janelia-kicad/step_dir_controller_3x2/schematic/step_dir_controller_3x2.pdf

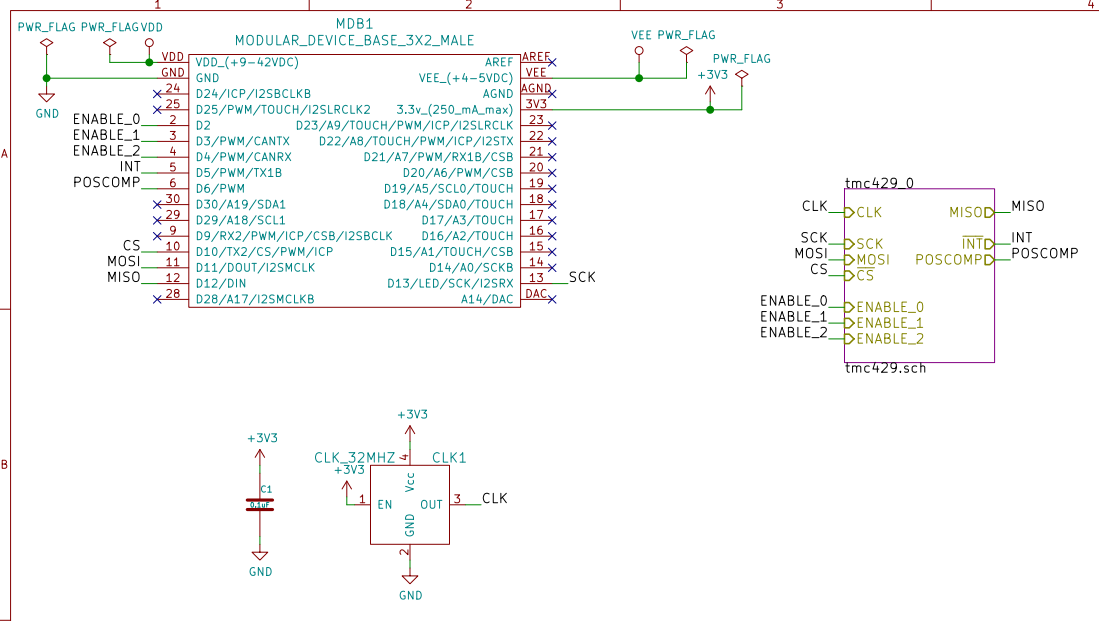
[picture p6: page 1]

File: step_dir_controller_3x2.sch Sheet: / Janelia

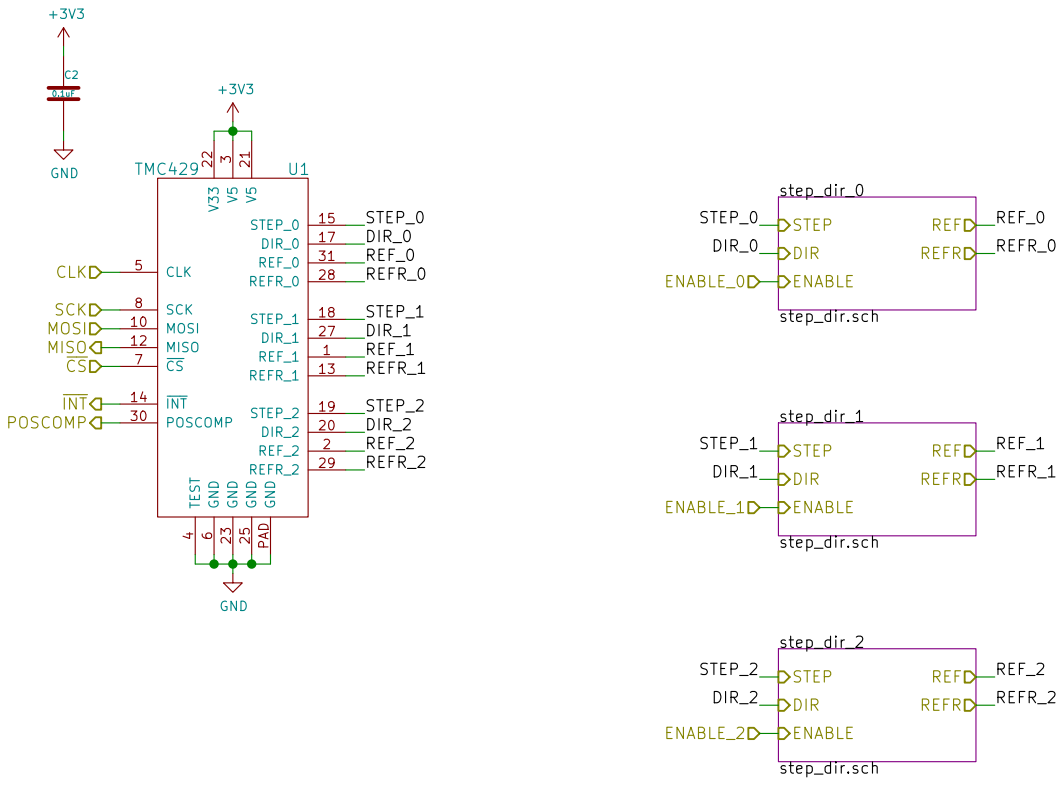
[picture p7: page 2]

6 CS 7 SCK 8 MOSI 10 DIR_2 POSCOMP 20

Id: 2/5 Title: File: tmc429.sch Sheet: /tmc429_0/

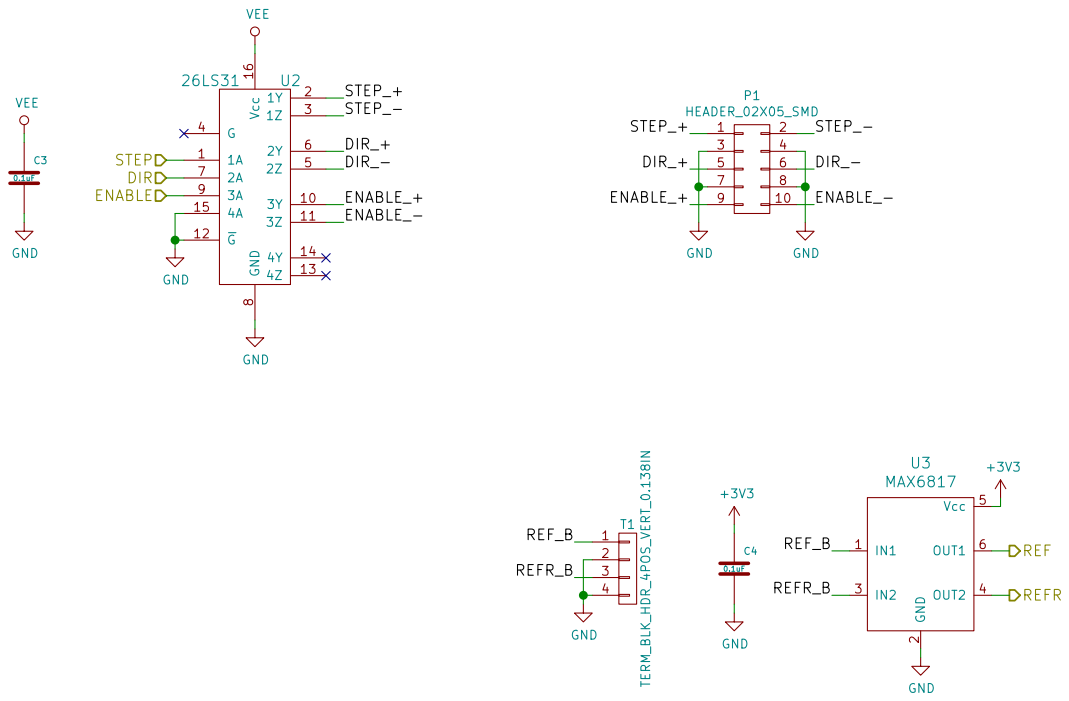
[picture p8: page 3]

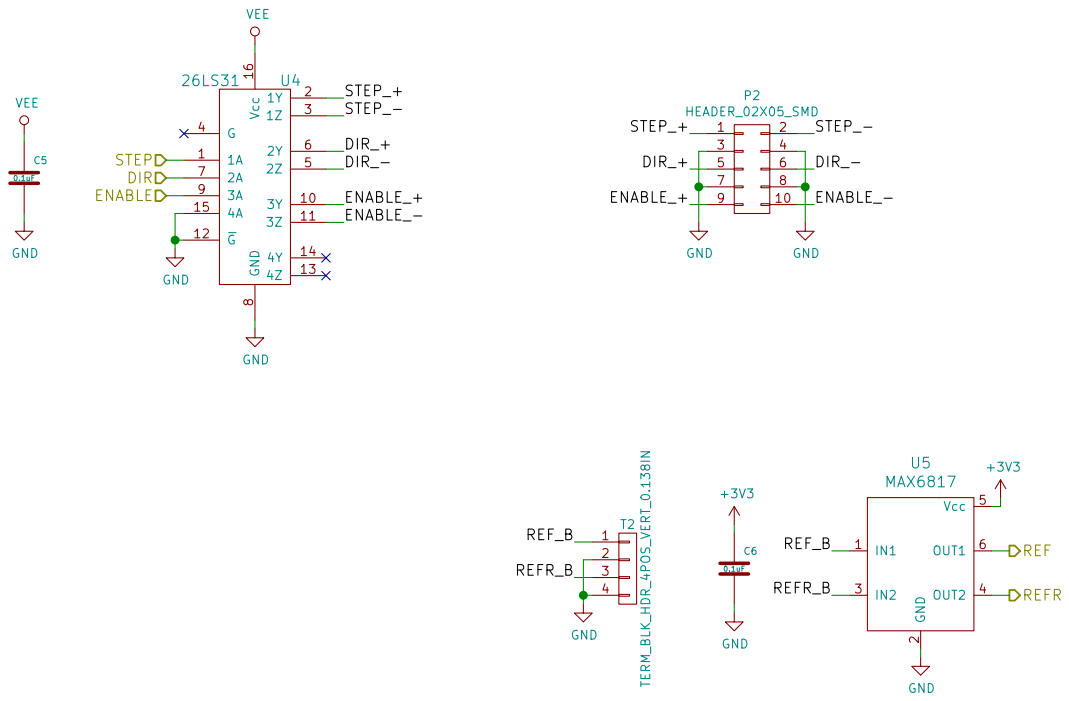
[picture p9: page 4]

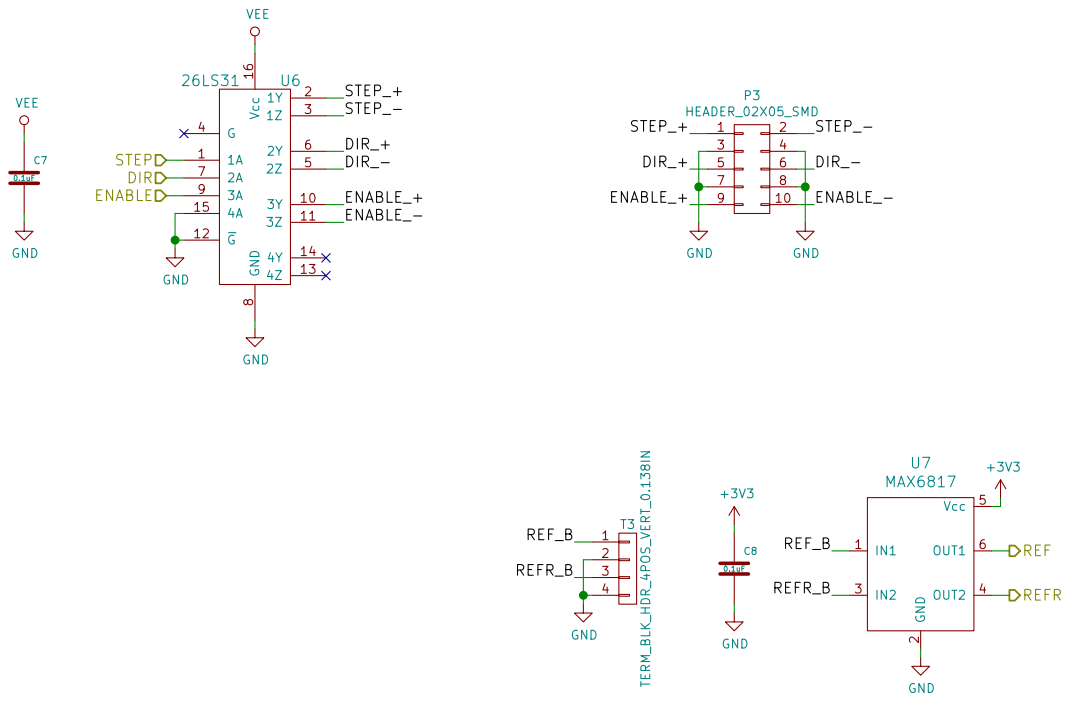
[picture p10: page 5]
