janelia-kicad/step_dir_controller_3x2/step_dir_controller_3x2.kicad_pcb

## KiCad design step_dir_controller_3x2.kicad_pcb (2017-03-29)

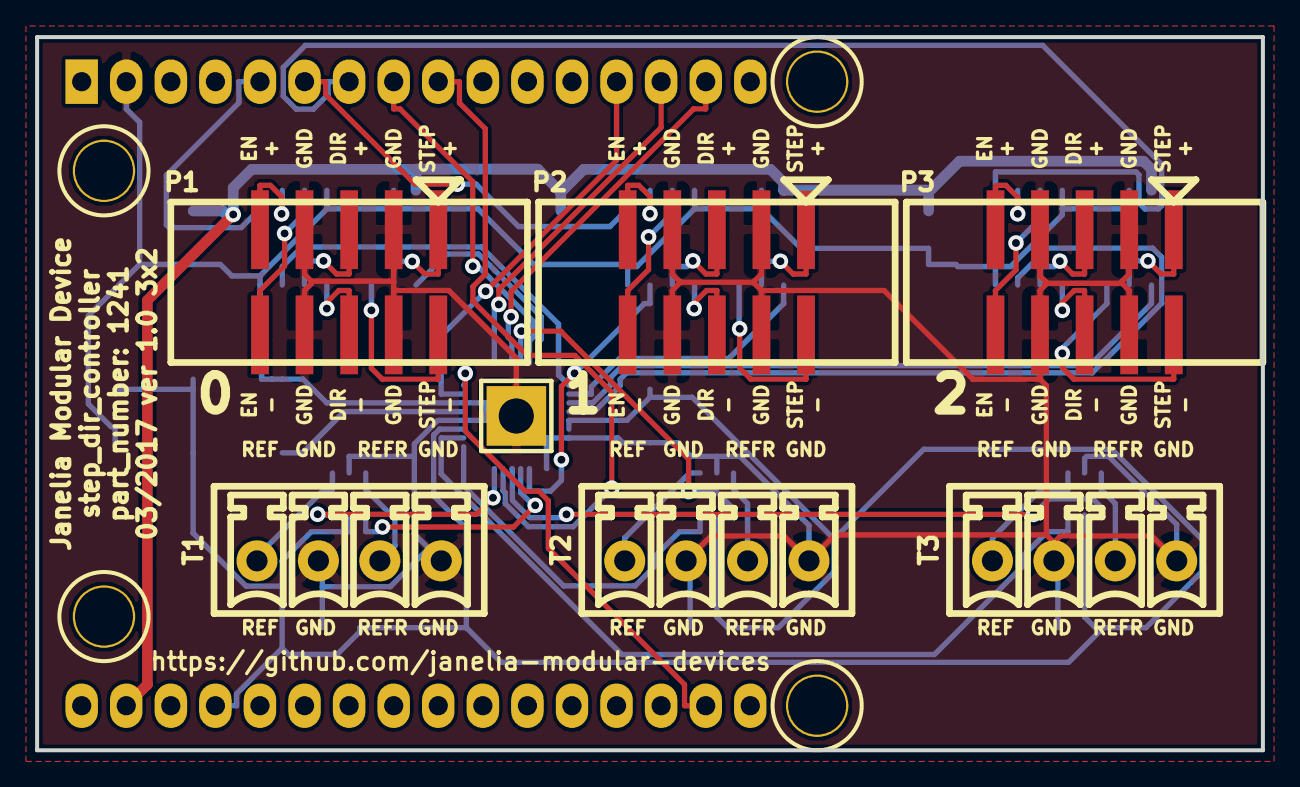
[picture p11: board step_dir_controller_3x2.kicad_pcb from above]

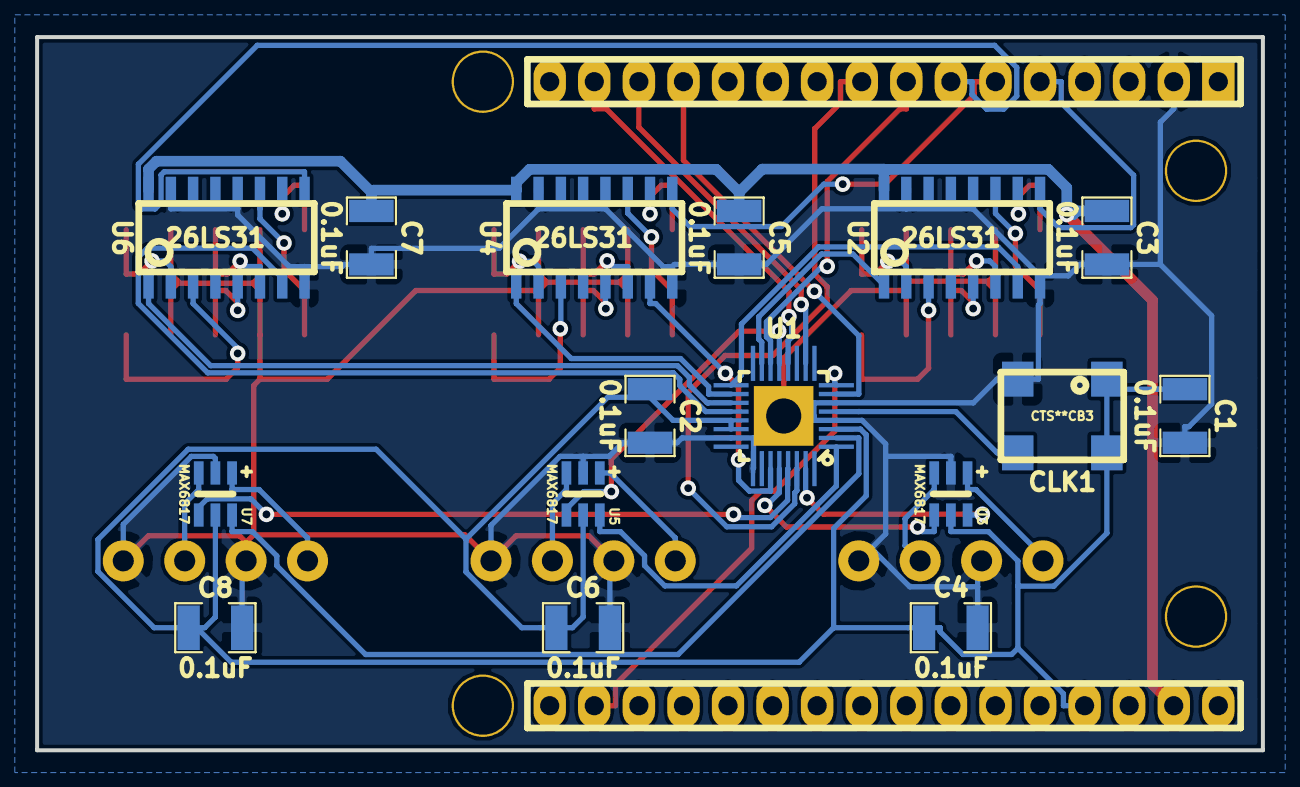
[picture p12: board step_dir_controller_3x2.kicad_pcb from below]

Board: 2 copper layers, 69.8 x 40.6 mm, 23 parts (16 on the bottom side), 49 nets.

Parts:
C1, C2, C3, C4, C5, C6, C7, C8: 0.1uF; SM1210
CLK1: CLK_32MHZ; CTS_SMD_4_7X5MM
MDB1: MODULAR_DEVICE_BASE_3X2_MALE
P1, P2, P3: HEADER_02X05_SMD; HEADER_02x05_SMD
T1, T2, T3: TERM_BLK_HDR_4POS_VERT_0.138IN
U1: TMC429; QFN-5x5-32
U2, U4, U6: 26LS31; SOIC_16_0.154IN
U3, U5, U7: MAX6817

Connections:
+3V3: C1.1, C2.1, C4.1, C6.1, C8.1, CLK1.1, CLK1.4, MDB1.3V3, U1.3, U1.21, U1.22, U3.5, U5.5, U7.5
/CLK: CLK1.3, U1.5
/CS: MDB1.10, U1.7
/ENABLE_0: MDB1.2, U2.9
/ENABLE_1: MDB1.3, U4.9
/ENABLE_2: MDB1.4, U6.9
/INT: MDB1.5, U1.14
/MISO: MDB1.12, U1.12
/MOSI: MDB1.11, U1.10
/POSCOMP: MDB1.6, U1.30
/SCK: MDB1.13, U1.8
/tmc429_0/DIR_0: U1.17, U2.7
/tmc429_0/DIR_1: U1.27, U4.7
/tmc429_0/DIR_2: U1.20, U6.7
/tmc429_0/REFR_0: U1.28, U3.4
/tmc429_0/REFR_1: U1.13, U5.4
/tmc429_0/REFR_2: U1.29, U7.4
/tmc429_0/REF_0: U1.31, U3.6
/tmc429_0/REF_1: U1.1, U5.6
/tmc429_0/REF_2: U1.2, U7.6
/tmc429_0/STEP_0: U1.15, U2.1
/tmc429_0/STEP_1: U1.18, U4.1
/tmc429_0/STEP_2: U1.19, U6.1
/tmc429_0/step_dir_0/DIR_+: P1.5, U2.6
/tmc429_0/step_dir_0/DIR_-: P1.6, U2.5
/tmc429_0/step_dir_0/ENABLE_+: P1.9, U2.10
/tmc429_0/step_dir_0/ENABLE_-: P1.10, U2.11
/tmc429_0/step_dir_0/REFR_B: T1.3, U3.3
/tmc429_0/step_dir_0/REF_B: T1.1, U3.1
/tmc429_0/step_dir_0/STEP_+: P1.1, U2.2
/tmc429_0/step_dir_0/STEP_-: P1.2, U2.3
/tmc429_0/step_dir_1/DIR_+: P2.5, U4.6
/tmc429_0/step_dir_1/DIR_-: P2.6, U4.5
/tmc429_0/step_dir_1/ENABLE_+: P2.9, U4.10
/tmc429_0/step_dir_1/ENABLE_-: P2.10, U4.11
/tmc429_0/step_dir_1/REFR_B: T2.3, U5.3
/tmc429_0/step_dir_1/REF_B: T2.1, U5.1
/tmc429_0/step_dir_1/STEP_+: P2.1, U4.2
/tmc429_0/step_dir_1/STEP_-: P2.2, U4.3
/tmc429_0/step_dir_2/DIR_+: P3.5, U6.6
/tmc429_0/step_dir_2/DIR_-: P3.6, U6.5
/tmc429_0/step_dir_2/ENABLE_+: P3.9, U6.10
/tmc429_0/step_dir_2/ENABLE_-: P3.10, U6.11
/tmc429_0/step_dir_2/REFR_B: T3.3, U7.3
/tmc429_0/step_dir_2/REF_B: T3.1, U7.1
/tmc429_0/step_dir_2/STEP_+: P3.1, U6.2
/tmc429_0/step_dir_2/STEP_-: P3.2, U6.3
GND: C1.2, C2.2, C3.2, C4.2, C5.2, C6.2, C7.2, C8.2, CLK1.2, MDB1.GND, P1.3, P1.4, P1.7, P1.8, P2.3, P2.4, P2.7, P2.8, P3.3, P3.4, P3.7, P3.8, T1.2, T1.4, T2.2, T2.4, T3.2, T3.4, U1.4, U1.6, U1.23, U1.25, U1.PAD, U2.8, U2.12, U2.15, U3.2, U4.8, U4.12, U4.15, U5.2, U6.8, U6.12, U6.15, U7.2
VEE: C3.1, C5.1, C7.1, MDB1.VEE, U2.16, U4.16, U6.16
