janelia-kicad/step_dir_controller_3x2/(commit log)

2017-03-27 Initial commit.
    [bom_pcb.csv, bom_pcb_add.csv, digikey_order_pcb.csv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]
2017-03-28 Added components and footprints.
    [step_dir_controller_3x2.sch, tmc429.sch]
2017-03-28 Progress towards v1.0.
    [step_dir.sch, step_dir_controller_3x2.sch, tmc429.sch]
2017-03-29 Finished schematic.
    [step_dir.sch, step_dir_controller_3x2.sch, tmc429.sch]
2017-03-29 Updated schematic outputs.
    [bom_pcb.csv, digikey_order_pcb.csv]
2017-03-29 Finished v1.0.
    [bom_pcb.csv, bom_pcb_add.csv, digikey_order.csv, digikey_order_pcb.csv, digikey_order_pcb_add.csv, step_dir.sch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]
2017-09-13 Updated 0.1uF capacitors.
    [bom_pcb.csv, digikey_order.csv, digikey_order_pcb.csv, step_dir.sch, step_dir_controller_3x2.sch, tmc429.sch]
2017-11-20 janelia-idf -> janelia-experimental-technology
    [step_dir.sch, step_dir_controller_3x2.sch, tmc429.sch]
2018-01-08 Updated to v4. Revert "janelia-idf -> janelia-experimental-technology"
    This reverts commit 833d96b9c9f5eb1d51ad25fc52d78d0d5fe98aec.
    [step_dir.sch, step_dir_controller_3x2.sch, tmc429.sch]
2018-08-12 Marked extra Teensy pins.
2018-10-24 Updated documentation.
    [bom_pcb.csv, bom_pcb_add.csv, digikey_order.csv, digikey_parts.csv, supplemental_digikey_parts.csv]
2021-09-21 Remove ignored files
    [step_dir_controller_3x2.dsn]
